Rocco83/esphome-fan-controller/rack-fan-pcb/production/bom.csv

Designator | Footprint | Quantity | Value | LCSC Part #
C1 | CP_Radial_D10.0mm_P5.00mm | 1 | 470uF 35V
C2 | CP_Radial_D5.0mm_P2.50mm | 1 | 47uF 10V
C3 | CP_Radial_D6.3mm_P2.50mm | 1 | 470uF 10V
D1 | D_DO-201AD_P12.70mm_Horizontal | 1 | 1N5822
F1 | Fuseholder_Cylinder-5x20mm_Stelvio-Kontek_PTF78_Horizontal_Open | 1 | T2A 5x20
J1 | TerminalBlock_Phoenix_MKDS-1,5-2-5.08_1x02_P5.08mm_Horizontal | 1 | + 24V IN -
J11 | FanPinHeader_1x04_P2.54mm_Vertical | 1 | FAN1
J12 | FanPinHeader_1x04_P2.54mm_Vertical | 1 | FAN2
J13 | FanPinHeader_1x04_P2.54mm_Vertical | 1 | FAN3
J14 | FanPinHeader_1x04_P2.54mm_Vertical | 1 | FAN4
J15 | FanPinHeader_1x04_P2.54mm_Vertical | 1 | FAN5
J16 | FanPinHeader_1x04_P2.54mm_Vertical | 1 | FAN6
J2 | PinHeader_1x03_P2.54mm_Vertical | 1 | UART
J21 | JST_XH_B3B-XH-A_1x03_P2.50mm_Vertical | 1 | TEMP1
J22 | JST_XH_B3B-XH-A_1x03_P2.50mm_Vertical | 1 | TEMP3
J23 | JST_XH_B3B-XH-A_1x03_P2.50mm_Vertical | 1 | TEMP5
J24 | JST_XH_B3B-XH-A_1x03_P2.50mm_Vertical | 1 | TEMP7
J25 | JST_XH_B3B-XH-A_1x03_P2.50mm_Vertical | 1 | TEMP2
J26 | JST_XH_B3B-XH-A_1x03_P2.50mm_Vertical | 1 | TEMP4
J27 | JST_XH_B3B-XH-A_1x03_P2.50mm_Vertical | 1 | TEMP6
J28 | JST_XH_B3B-XH-A_1x03_P2.50mm_Vertical | 1 | TEMP8
J3 | PinHeader_1x03_P2.54mm_Vertical | 1 | RESET
J4 | PinHeader_1x03_P2.54mm_Vertical | 1 | BOOT
J5 | BarrelJack_Horizontal | 1 | 24V IN 5.5/2.5
Q1, Q2, Q3, Q4, Q5, Q6 | TO-92_Inline_Wide | 6 | 2N3904
R1, R2, R3, R31, R32, R4, R5, R6 | R_Axial_DIN0207_L6.3mm_D2.5mm_P7.62mm_Horizontal | 8 | 4.7k
R11, R12, R13, R14, R15, R16 | R_Axial_DIN0207_L6.3mm_D2.5mm_P7.62mm_Horizontal | 6 | 100k
R21, R22, R23, R24, R25, R26 | R_Axial_DIN0207_L6.3mm_D2.5mm_P7.62mm_Horizontal | 6 | 10k
U1 | WT32-ETH01_Socket_FaceDown | 1 | WT32-ETH01
U2 | Converter_DCDC_TRACO_TSR-1_THT | 1 | TSR 1-2450
