Rocco83/esphome-fan-controller/rack-fan-pcb/rack-fan-pcb.kicad_pcb

## KiCad design rack-fan-pcb/rack-fan-pcb.kicad_pcb (2026-11-03)

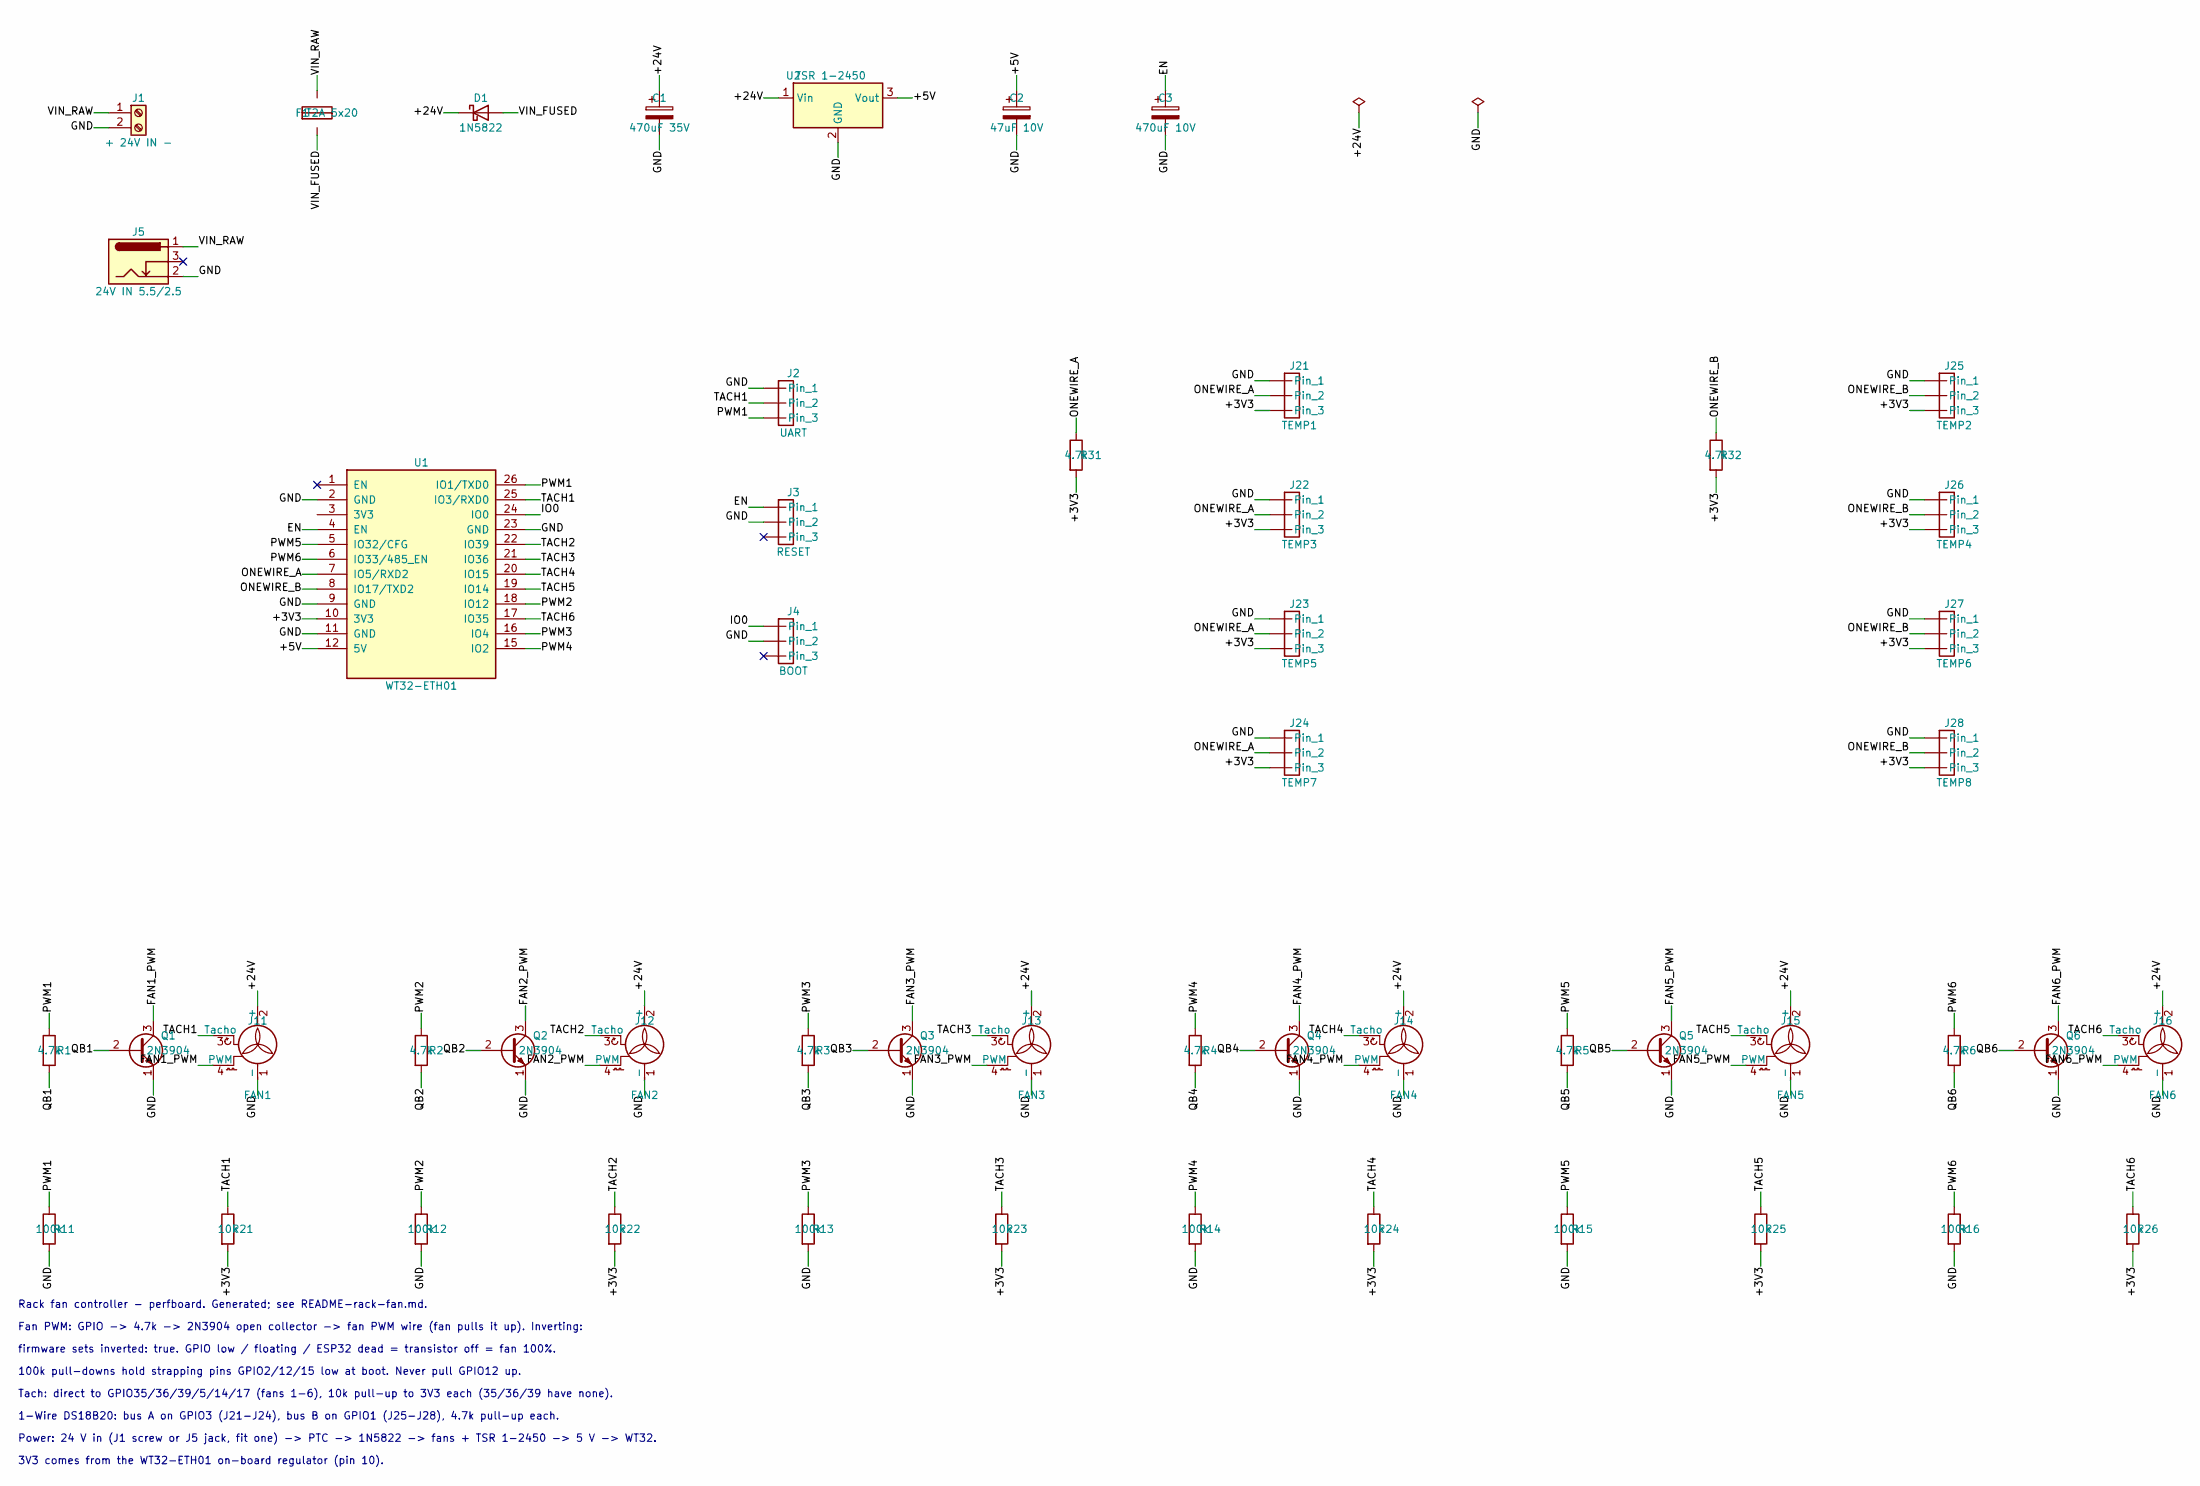
[picture p8: schematic rack-fan-pcb.kicad_sch, Rack fan controller (WT32-ETH01, 6 fans, 8 probes)]

Parts:
C1: 470uF 35V; CP_Radial_D10.0mm_P5.00mm
C2: 47uF 10V; CP_Radial_D5.0mm_P2.50mm
C3: 470uF 10V; CP_Radial_D6.3mm_P2.50mm
D1: 1N5822; D_DO-201AD_P12.70mm_Horizontal
F1: T2A 5x20; Fuseholder_Cylinder-5x20mm_Stelvio-Kontek_PTF78_Horizontal_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
J1: + 24V IN -; TerminalBlock_Phoenix_MKDS-1,5-2-5.08_1x02_P5.08mm_Horizont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
J2: UART; PinHeader_1x03_P2.54mm_Vertical
J3: RESET; PinHeader_1x03_P2.54mm_Vertical
J4: BOOT; PinHeader_1x03_P2.54mm_Vertical
J5: 24V IN 5.5/2.5; BarrelJack_Horizontal
J11: FAN1; FanPinHeader_1x04_P2.54mm_Vertical
J12: FAN2; FanPinHeader_1x04_P2.54mm_Vertical
J13: FAN3; FanPinHeader_1x04_P2.54mm_Vertical
J14: FAN4; FanPinHeader_1x04_P2.54mm_Vertical
J15: FAN5; FanPinHeader_1x04_P2.54mm_Vertical
J16: FAN6; FanPinHeader_1x04_P2.54mm_Vertical
J21: TEMP1; JST_XH_B3B-XH-A_1x03_P2.50mm_Vertical
J22: TEMP3; JST_XH_B3B-XH-A_1x03_P2.50mm_Vertical
J23: TEMP5; JST_XH_B3B-XH-A_1x03_P2.50mm_Vertical
J24: TEMP7; JST_XH_B3B-XH-A_1x03_P2.50mm_Vertical
J25: TEMP2; JST_XH_B3B-XH-A_1x03_P2.50mm_Vertical
J26: TEMP4; JST_XH_B3B-XH-A_1x03_P2.50mm_Vertical
J27: TEMP6; JST_XH_B3B-XH-A_1x03_P2.50mm_Vertical
J28: TEMP8; JST_XH_B3B-XH-A_1x03_P2.50mm_Vertical
Q1, Q2, Q3, Q4, Q5, Q6: 2N3904; TO-92_Inline_Wide
R1, R2, R3, R4, R5, R6, R31, R32: 4.7k; R_Axial_DIN0207_L6.3mm_D2.5mm_P7.62mm_Horizontal
R11, R12, R13, R14, R15, R16: 100k; R_Axial_DIN0207_L6.3mm_D2.5mm_P7.62mm_Horizontal
R21, R22, R23, R24, R25, R26: 10k; R_Axial_DIN0207_L6.3mm_D2.5mm_P7.62mm_Horizontal
U1: WT32-ETH01; WT32-ETH01_Socket_FaceDown
U2: TSR 1-2450; Converter_DCDC_TRACO_TSR-1_THT

Connections:
/+3V3: J21.3, J22.3, J23.3, J24.3, J25.3, J26.3, J27.3, J28.3, R21.2, R22.2, R23.2, R24.2, R25.2, R26.2, R31.2, R32.2, U1.3 (3V3), U1.10 (3V3)
/+5V: C2.1, U1.12 (5V), U2.3 (Vout)
/+24V: C1.1, D1.1 (K), J11.2 (+), J12.2 (+), J13.2 (+), J14.2 (+), J15.2 (+), J16.2 (+), U2.1 (Vin)
/EN: C3.1, J3.1, U1.4 (EN)
/FAN1_PWM: J11.4 (PWM), Q1.3 (C)
/FAN2_PWM: J12.4 (PWM), Q2.3 (C)
/FAN3_PWM: J13.4 (PWM), Q3.3 (C)
/FAN4_PWM: J14.4 (PWM), Q4.3 (C)
/FAN5_PWM: J15.4 (PWM), Q5.3 (C)
/FAN6_PWM: J16.4 (PWM), Q6.3 (C)
/GND: C1.2, C2.2, C3.2, J1.2, J2.1, J3.2, J4.2, J5.2, J11.1 (-), J12.1 (-), J13.1 (-), J14.1 (-), J15.1 (-), J16.1 (-), J21.1, J22.1, J23.1, J24.1, J25.1, J26.1, J27.1, J28.1, Q1.1 (E), Q2.1 (E), Q3.1 (E), Q4.1 (E), Q5.1 (E), Q6.1 (E), R11.2, R12.2, R13.2, R14.2, R15.2, R16.2, U1.2 (GND), U1.9 (GND), U1.11 (GND), U1.23 (GND), U2.2 (GND)
/IO0: J4.1, U1.24 (IO0)
/ONEWIRE_A: J21.2, J22.2, J23.2, J24.2, R31.1, U1.7 (IO5/RXD2)
/ONEWIRE_B: J25.2, J26.2, J27.2, J28.2, R32.1, U1.8 (IO17/TXD2)
/PWM1: J2.3, R1.1, R11.1, U1.26 (IO1/TXD0)
/PWM2: R2.1, R12.1, U1.18 (IO12)
/PWM3: R3.1, R13.1, U1.16 (IO4)
/PWM4: R4.1, R14.1, U1.15 (IO2)
/PWM5: R5.1, R15.1, U1.5 (IO32/CFG)
/PWM6: R6.1, R16.1, U1.6 (IO33/485_EN)
/QB1: Q1.2 (B), R1.2
/QB2: Q2.2 (B), R2.2
/QB3: Q3.2 (B), R3.2
/QB4: Q4.2 (B), R4.2
/QB5: Q5.2 (B), R5.2
/QB6: Q6.2 (B), R6.2
/TACH1: J2.2, J11.3 (Tacho), R21.1, U1.25 (IO3/RXD0)
/TACH2: J12.3 (Tacho), R22.1, U1.22 (IO39)
/TACH3: J13.3 (Tacho), R23.1, U1.21 (IO36)
/TACH4: J14.3 (Tacho), R24.1, U1.20 (IO15)
/TACH5: J15.3 (Tacho), R25.1, U1.19 (IO14)
/TACH6: J16.3 (Tacho), R26.1, U1.17 (IO35)
/VIN_FUSED: D1.2 (A), F1.2
/VIN_RAW: F1.1, J1.1, J5.1

Notes on the sheet:
Tach: direct to GPIO35/36/39/5/14/17 (fans 1-6), 10k pull-up to 3V3 each (35/36/39 have none).
firmware sets inverted: true. GPIO low / floating / ESP32 dead = transistor off = fan 100%.
1-Wire DS18B20: bus A on GPIO3 (J21-J24), bus B on GPIO1 (J25-J28), 4.7k pull-up each.
Rack fan controller - perfboard. Generated; see README-rack-fan.md.
100k pull-downs hold strapping pins GPIO2/12/15 low at boot. Never pull GPIO12 up.
Fan PWM: GPIO -> 4.7k -> 2N3904 open collector -> fan PWM wire (fan pulls it up). Inverting:
3V3 comes from the WT32-ETH01 on-board regulator (pin 10).
Power: 24 V in (J1 screw or J5 jack, fit one) -> PTC -> 1N5822 -> fans + TSR 1-2450 -> 5 V -> WT32.

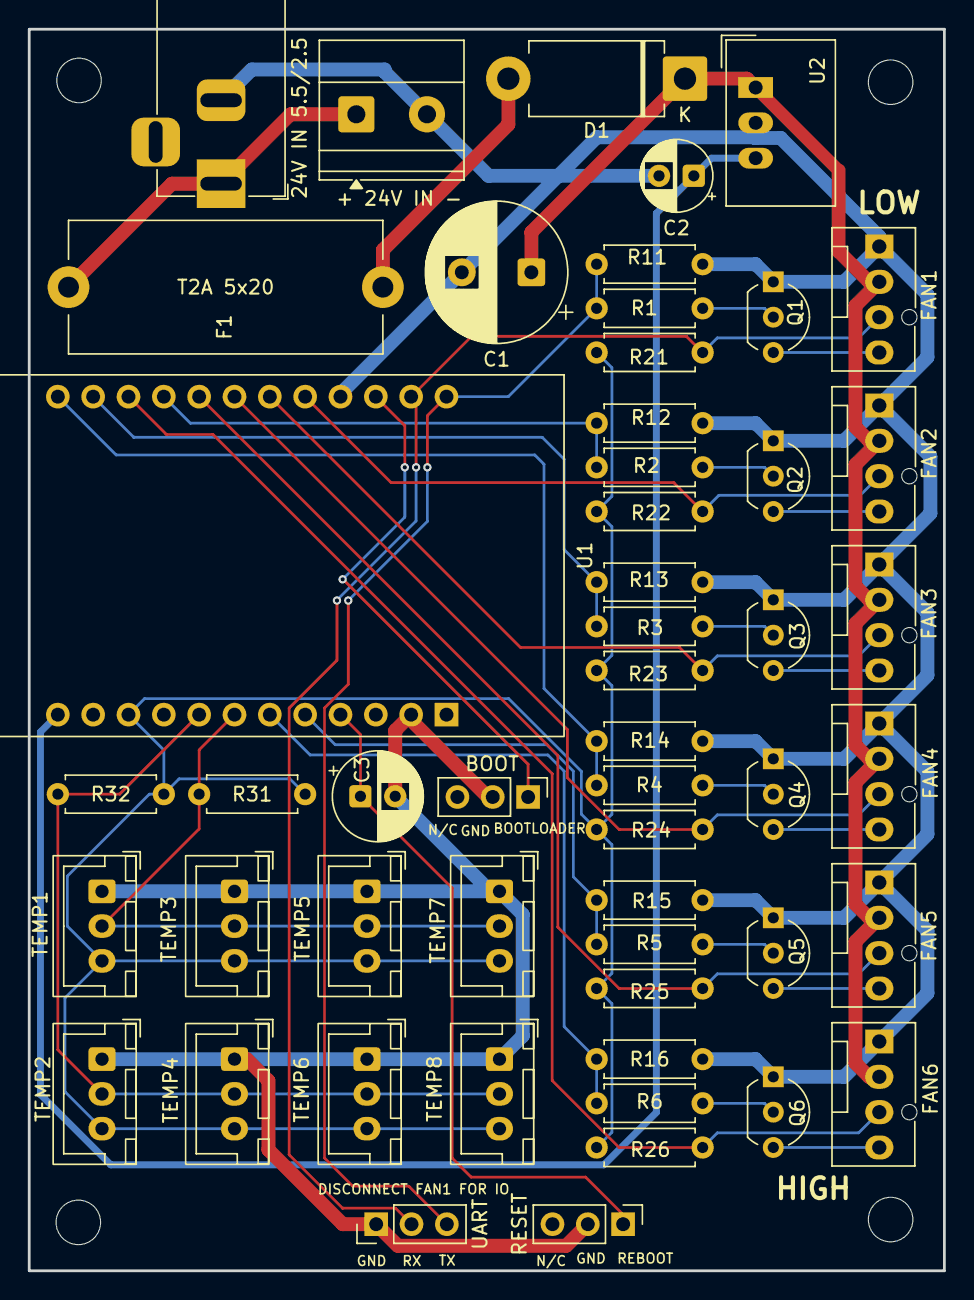
[picture p9: board rack-fan-pcb.kicad_pcb from above]

Board: 2 copper layers, 65.8 x 89.3 mm, 56 parts (0 on the bottom side), 34 nets.

Other parts of the board:
H1, H2, H3, H4: M3; MountingHole_3.2mm_M3
