Rocco83/esphome-fan-controller/(commit log)

2023-11-19 Several fixes
    - removed trail whitespaces
    - changed the code from DHT11 to DHT20 (and therefore i2c)
    - changed the GPIOs for the fan
    [console-fan.yaml]
2023-11-19 Replaced hardened "Console Fan", fixed $friendly_name
    - the iteration of "Console Fan" has been moved to ${friendly_name}
    - the iteration of $friendly_name has been moved to ${friendly_name}
    [console-fan.yaml]
2023-11-20 Stable release v1.0
    - changed the friendly name
    - changed the id names
    - moved the sht20 library to have a configurable delay
    - added the missing component of sht20 to avoid unnamed devices
    - moved the component logging to error to avoid the 20-20ms warning
    [console-fan.yaml]
2026-02-08 Fixed pinout, added comments
    [console-fan.yaml]
2026-11-03 Add rack fan controller: firmware, PCB, docs and test rig
    - rack-fan.yaml + rack-fan-channel.yaml: WT32-ETH01 (ESP-IDF) driving six
    24 V PWM fans with tach, DS18B20 probes cross split over two 1-Wire buses,
    probe scan button, Probe Missing alert, reset reason, no API reboot timeout
    - rack-fan-pcb/: KiCad 10 project and decision record
    - test-rig/: temporary 2-fan breadboard rig to verify every PWM/tach pin
    - serverroom-fan.yaml (was console-fan.yaml) with its own README
    - datasheets and photos of the original fan tray
    Claude-Session: https://claude.ai/code/session_01JSx38qGrs7iHPgEakbj5Et
2026-11-03 Rack fan: 8 probes, UART/RESET/BOOT headers, board as ordered
    Firmware (rack-fan.yaml):
    - 8 DS18B20 probes, odd TEMP connectors on bus A, even on bus B;
    hot zone = max(Rear High, Rear Mid, Front High)
    - Delta Inlet-Other Room (monitoring), Probe Missing alert, reset reason
    - API reboot_timeout disabled (control is standalone)
    PCB (rack-fan-pcb/):
    - J2 UART, J3 RESET, J4 BOOT 1x3 headers with linked silkscreen labels;
    IO0 track kept short (J4 next to C3)
    - WT32 pins 13/14 removed (past the board edge), 1x12 sockets
    - EN jumper pin group removed (KiCad split the EN net), pin 1 no-connect
    - F1 pad rotation back to library, min silk text height 0.7 mm
    - schematic TEMP values aligned with th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
2026-11-08 Rack fan: fan test mode, 25% kick-start, TEMP4/TEMP7 probe swap
    - Fan Test Mode: per-fan raw duty sliders (0-100 %), control logic and
    emergency bypassed, always off after reboot, auto-off after 60 min
    - kick-start: a fan commanded below fan_start_duty (25 %) that reads 0 RPM
    gets 25 % until it turns (bench test: a stopped NF-F12 24V-3000 does not
    start at 20-22 %; once running it keeps turning down to ~15 %)
    - TEMP4 Front High now the 5 m probe, TEMP7 Inlet the 2 m one
    - README: test mode, kick-start, cable lengths per connector
    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
